LiveLeds/AstraDriver/README.md

# AstraDriver

[GitHub IO Page](https://liveleds.github.io/AstraDriver)
