LiveLeds/AstraDriver/index.md

---
layout: home
---

{% assign cacheBust = site.time | date:'?v=%s' %}


4 Channel LED Driver with PWM dimming input. LED2001PHR is the driver IC,
it can support up to 4A, 3V - 18V at 850KHz switching frequency.
Test plugs for each input and output.
Optimized for good dimming performance.
The board connects to [AstraControl](https://liveleds.github.io/AstraControl) ESP32-based control PCB uses WiFi with an external antenna and 5Mbps RS-485.
Direct copper heat-sink PCB for LED diode [AstraBeamLED](https://liveleds.github.io/AstraBeamLED).

### Production Details

The PCB went into production on **April 9, 2025**.

- **Git Tag:** `production-2025.04.09`

### Received Product

##### Front

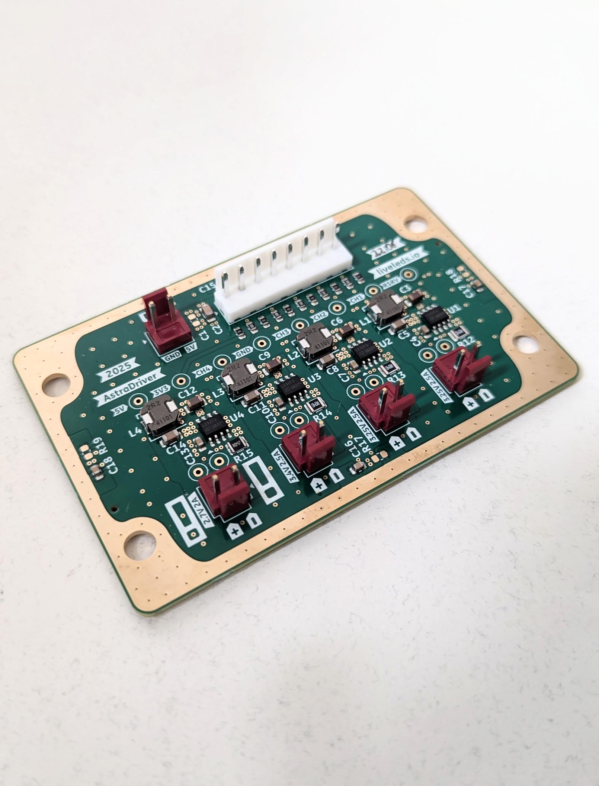
[picture p1: images/AstraDriver_Received_Front_Angled.jpg]
PCB Front


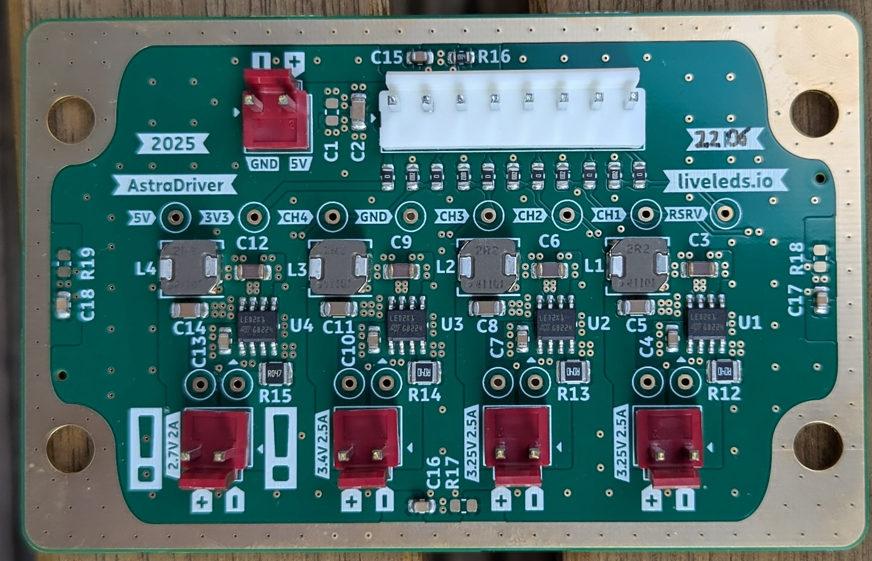
[picture p2: images/AstraDriver_Received_Front.jpg]
PCB Front


##### Back

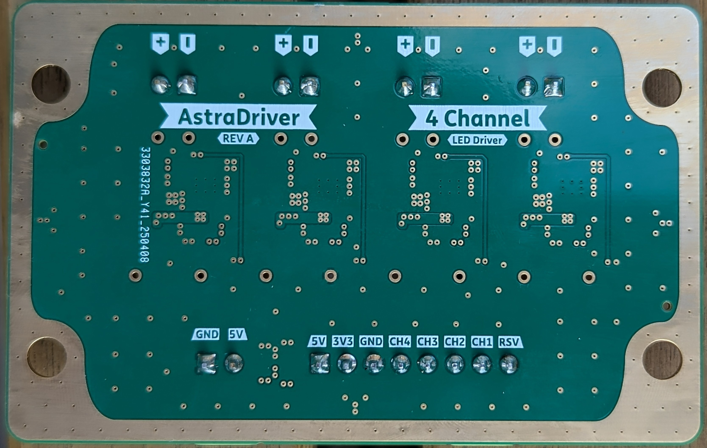
[picture p3: images/AstraDriver_Received_Back.jpg]
PCB Back


### Identified Issues

1. **Minor Coil Whine:**
  A very minor coil whine can be heard under full PWM operation, especially when going from 100% to 0%. It's not very critical for my use case but I fixed the issue by adding an electrolytic 1000uF capacitor into the test plug holes (5V and GND). Something to improve in the next revision. The existing 100uF ceramic is not performing well enough.

1. **Flicker at very low PWM:**
   When testing 14 bit PWM resolution the LEDs were flickering slightly at very low values (up to 150 around %1). It's was expected and I just limited it in software, it's still very dim and stable at 150. A potential solution is to use an N-Channel MOSFET to control which shunt resistor (current of 2.5A or 0.5A for example) is used and select the appropriate one for very low value to have a complete 0 to 100% range.
   An example of such an HDR approach can be found on Youtube here (8:36): [
Building My Ultimate LED Flashlight: Boost Driver Circuit Episode #1](https://www.youtube.com/watch?v=jCIWTuvKMyg) Credit to Engeneering Bo.

### Additional Notes

- Overall the whole project worked without significant issues on the first revision.
- The test plug hole were very useful to add an extra capacitor, debugging PWM and checking voltages.
  
### Continuous Integration and Repository Status





## Table of contents

- [Table of contents](#table-of-contents)
  - [Render Top Angled](#render-top-angled)
  - [Render Top](#render-top)
  - [Render Bottom](#render-bottom)
  - [Schematic](#schematic)
    - [Dark](#dark)
    - [Monochromatic](#monochromatic)
    - [Light](#light)
  - [Assembly](#assembly)
    - [Dark](#dark-1)
    - [Light](#light-1)
    - [Gerber viewer on tracespace.io](#gerber-viewer-on-tracespaceio)
  - [Interactive BOM](#interactive-bom)
  - [BOM](#bom)
  - [KiCad Revision Inspector (KiRI)](#kicad-revision-inspector-kiri)
    - [Dark](#dark-2)
    - [Light](#light-2)
  - [Downloads](#downloads)
    - [JLCPCB](#jlcpcb)
    - [Eurocircuits](#eurocircuits)
    - [3D Step](#3d-step)
- [Report](#report)
    - [ERC](#erc)
    - [DRC](#drc)
- [Know Issues](#know-issues)
- [Credits](#credits)

### Render Top Angled



### Render Top



### Render Bottom



### Schematic

#### Dark

- [Schematic Dark PDF]({{ "/documents/AstraDriver-schematic-dark.pdf" | absolute_url | append: cacheBust }})

#### Monochromatic

- [Schematic Monochromatic PDF]({{ "/documents/AstraDriver-schematic-mono.pdf" | absolute_url | append: cacheBust }})

#### Light

- [Schematic Light PDF]({{ "/documents/AstraDriver-schematic-default.pdf" | absolute_url | append: cacheBust }})

### Assembly

#### Dark

- [PCB Dark PDF]({{ "/documents/AstraDriver-pcb-dark.pdf" | absolute_url | append: cacheBust }})

#### Light

- [PCB Light PDF]({{ "/documents/AstraDriver-pcb-light.pdf" | absolute_url | append: cacheBust }})

#### Gerber viewer on tracespace.io

[https://tracespace.io/view/?boardUrl={{ "export/AstraDriver-JLCPCB.zip" | absolute_url | append: cacheBust }}](https://tracespace.io/view/?boardUrl={{ "export/AstraDriver-JLCPCB.zip" | absolute_url | append: cacheBust }})

### Interactive BOM

Check component locations by hovering over a specific component.
The visual elements might not be precise enough for pcb review but can be very useful since it's possible to pan and zoom.
Not all BOM columns are available here, for datasheet links see BOM below.

[IBOM HTML]({{ "/export/AstraDriver-ibom.html" | absolute_url | append: cacheBust }})

### BOM

All components with Values, References, Sheetpath and Links to the datasheet.

[BOM HTML]({{ "/export/AstraDriver-bom.html" | absolute_url | append: cacheBust }})

### KiCad Revision Inspector (KiRI)

KiCad Revision Inspector (KiRI) is a tool for comparing different versions of KiCad projects. It exports project revisions to SVG format for visual comparison using an onion skin view. This helps identify changes and errors in PCB designs. KiRI also includes a command line interface for generating viewable artifacts in any web browser.

View the PCB / Schematic in an interactive way, pan and zoom to see the details.

#### Dark

- [KiRi Dark]({{ "/KiRiDark/index.html" | absolute_url | append: cacheBust }})

#### Light

- [KiRi Light]({{ "/KiRiLight/index.html" | absolute_url | append: cacheBust }})

### Downloads

#### JLCPCB

- [JLCPCB Zip]({{ "export/AstraDriver-JLCPCB.zip" | absolute_url | append: cacheBust }})
- [JLCPCB BOM CSV]({{ "export/AstraDriver_bom_jlc.csv" | absolute_url | append: cacheBust }})
- [JLCPCB CPL CSV]({{ "export/AstraDriver_cpl_jlc.csv" | absolute_url | append: cacheBust }})

#### Eurocircuits

- [Eurocircuits Zip]({{ "export/AstraDriver-Eurocircuits.zip" | absolute_url | append: cacheBust }})
- [Eurocircuits BOM CSV]({{ "export/AstraDriver_bom_Eurocircuits.csv" | absolute_url | append: cacheBust }})
- [Eurocircuits CPL CSV]({{ "export/AstraDriver_cpl_Eurocircuits.csv" | absolute_url | append: cacheBust }})

#### 3D Step

- [3D Step]({{ "/AstraDriver-3D.step" | absolute_url | append: cacheBust }})

## Report

#### ERC

{% include_relative erc_validation.md %}

#### DRC

{% include_relative drc_validation.md %}

{% include_relative AstraDriver-report.md %}

## Know Issues

- TBD

## Credits

[KiCad EDA](https://www.kicad.org)

[KiBot](https://github.com/INTI-CMNB/KiBot)

[Amulet - Inspiration for awesome schematic and PCB](https://github.com/EPFLXplore/XRE_LeggedRobot_HW)

[tracespace view - Online Gerber Viewer](https://tracespace.io)
