LiveLeds/AstraDriver/dxf/AstraDriverRing.dxf

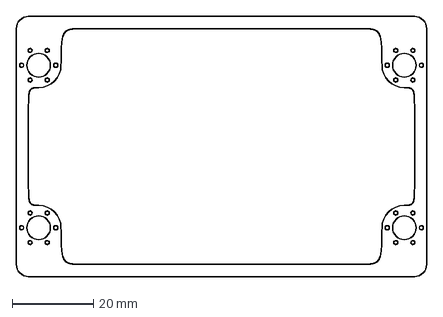
[picture p4: CAD file, 2025-02-16]
dxf/AstraDriverRing.dxf
101.0 x 64.0 mm
