LiveLeds/AstraDriver/dxf/AstraDriverEdge.dxf

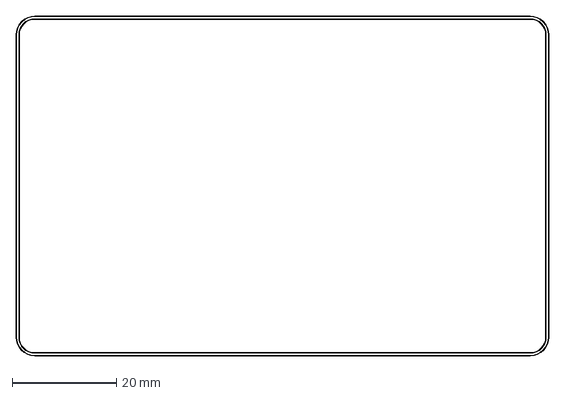
[picture p5: CAD file, 2025-02-16]
dxf/AstraDriverEdge.dxf
102.0 x 65.0 mm
