LiveLeds/AstraDriver/AstraDriverPCB/AstraDriver.kicad_pcb

## KiCad design AstraDriverPCB/AstraDriver.kicad_pcb (2025-04-04)

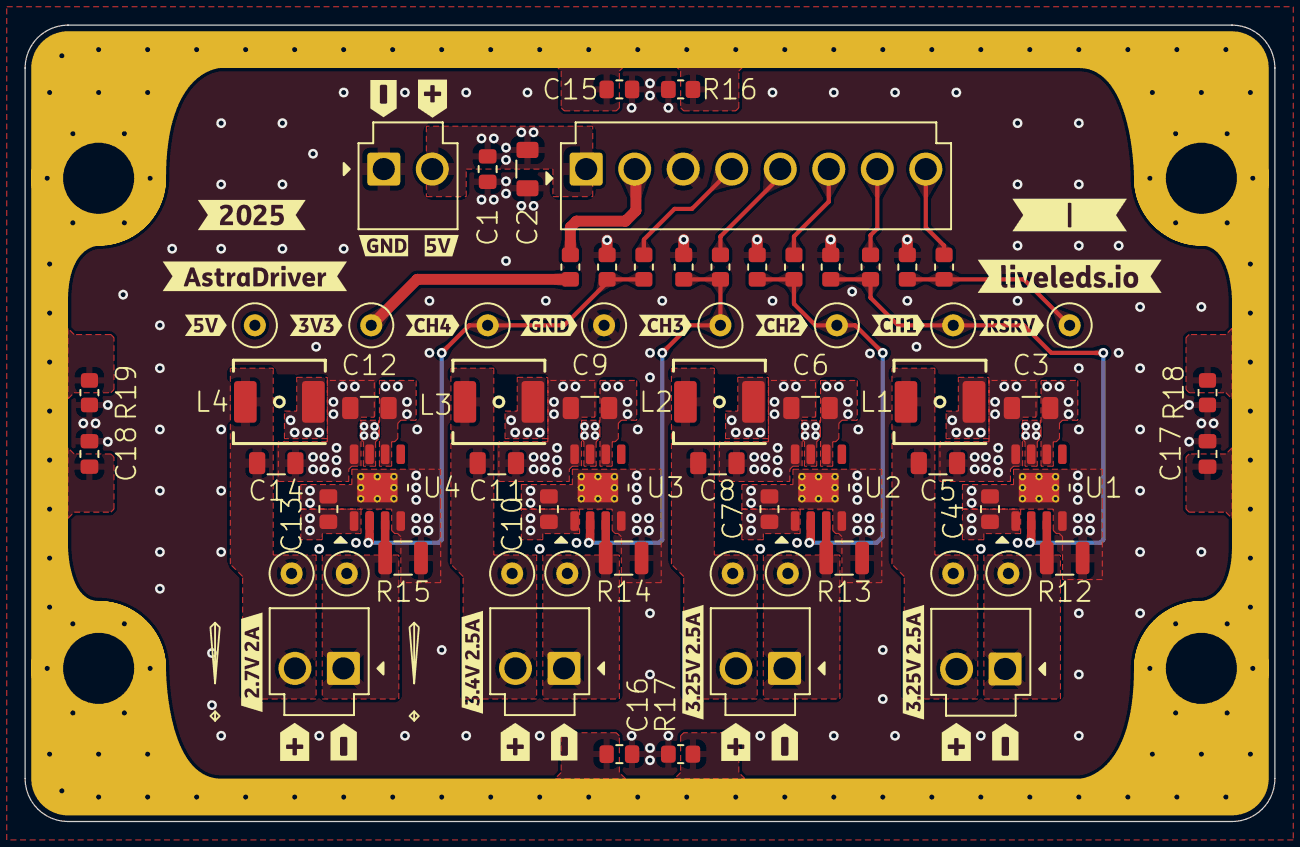
[picture p6: board AstraDriver.kicad_pcb from above]

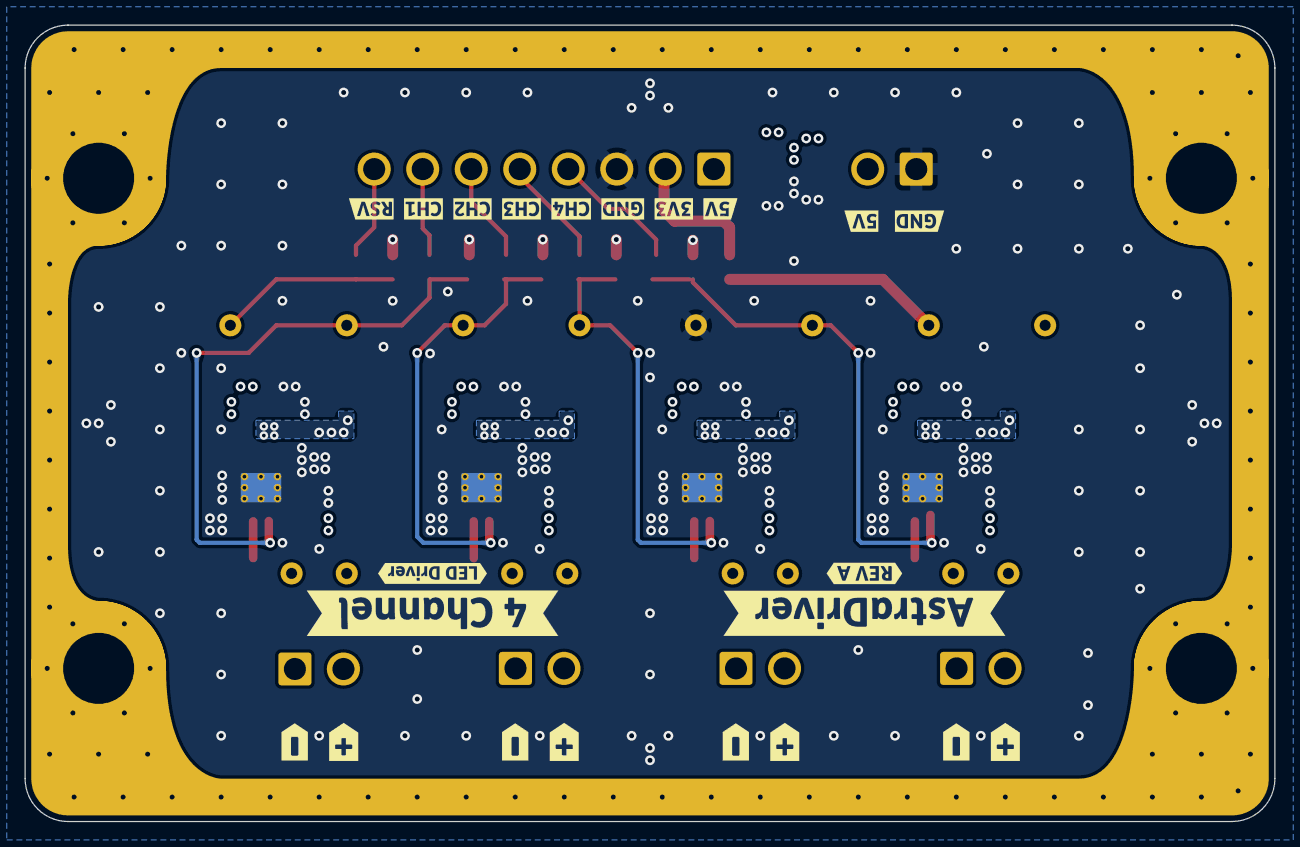
[picture p7: board AstraDriver.kicad_pcb from below]

Board: 4 copper layers, 102.0 x 65.0 mm, 118 parts (22 on the bottom side), 27 nets.

Parts:
C1: DNP; C_DNP_0805_2012Metric_Pad1.18x1.45mm_HandSolder
C2: 100u; C_1206_3216Metric_Pad1.33x1.80mm_HandSolder
C3, C6, C9, C12: 22u; C_1206_3216Metric_Pad1.33x1.80mm_HandSolder
C4, C7, C10, C13: 1u; C_0805_2012Metric_Pad1.18x1.45mm_HandSolder
C5, C8, C11, C14: 4u7; C_1206_3216Metric_Pad1.33x1.80mm_HandSolder
C15, C16, C17, C18: 10n; C_0805_2012Metric_Pad1.18x1.45mm_HandSolder
CN1: JST VH 8 PIN (CLONE); JST_VH_CLONE_B8P-VH-B_1x08_P3.96mm_Vertical
CN2, CN3, CN4, CN5, CN6: JST VH 2 PIN; JST_VH_B2P-VH-B_1x02_P3.96mm_Vertical
L1, L2, L3, L4: 2u2H; L_TDK_SPM6530T-2R2M
R1, R2, R3, R4, R5, R6: 0; R_0805_2012Metric_Pad1.20x1.40mm_HandSolder
R7, R8, R9, R10, R11: 10k; R_0805_2012Metric_Pad1.20x1.40mm_HandSolder
R12, R13, R14: 40m; R_1210_3225Metric
R15: 47m; R_1210_3225Metric
R16: 1M; R_0805_2012Metric_Pad1.20x1.40mm_HandSolder
R17, R18, R19: DNP; R_DNP_0805_2012Metric_Pad1.20x1.40mm_HandSolder
RING1: AstraDriver_Ground_Ring
TP1, TP2, TP3, TP4, TP5, TP6, TP7, TP8, TP9, TP10, TP11, TP12, TP13, TP14, TP15, TP16: TestPoint_Thimble; TestPoint_Loop_D3.50mm_Drill0.9mm_Beaded
U1, U2, U3, U4: LED2001PHR; U_LED2001PHR_HSOP8
kibuzzard-67ACE9FE: G***; kibuzzard-67ACE9FE
kibuzzard-67ACEA04: G***; kibuzzard-67ACEA04
kibuzzard-67B0BCB5: G***; kibuzzard-67B0BCB5
kibuzzard-67B1DE0F: G***; kibuzzard-67B1DE0F
kibuzzard-67B1DE14: G***; kibuzzard-67B1DE14
kibuzzard-67B1DE99, kibuzzard-67B1DE99#2, kibuzzard-67B1DE99#3, kibuzzard-67B1DE99#4: G***; kibuzzard-67B1DE99
kibuzzard-67B1DEA2, kibuzzard-67B1DEA2#2, kibuzzard-67B1DEA2#3, kibuzzard-67B1DEA2#4: G***; kibuzzard-67B1DEA2
kibuzzard-67B1DFB0: G***; kibuzzard-67B1DFB0
kibuzzard-67B1DFC8: G***; kibuzzard-67B1DFC8
kibuzzard-67EB9EA5: G***; kibuzzard-67EB9EA5
kibuzzard-67EB9FE0: G***; kibuzzard-67EB9FE0
kibuzzard-67263EBF: G***; kibuzzard-67263EBF
kibuzzard-67263F1F: G***; kibuzzard-67263F1F
kibuzzard-67263F3C: G***; kibuzzard-67263F3C
kibuzzard-67263F3F: G***; kibuzzard-67263F3F
kibuzzard-67263F8C: G***; kibuzzard-67263F8C
kibuzzard-67263F35: G***; kibuzzard-67263F35
kibuzzard-67263F87: G***; kibuzzard-67263F87
kibuzzard-67264EAC: G***; kibuzzard-67264EAC
kibuzzard-67264F3E: G***; kibuzzard-67264F3E
kibuzzard-67264F60: G***; kibuzzard-67264F60
kibuzzard-67264F65: G***; kibuzzard-67264F65
kibuzzard-67609A4F: G***; kibuzzard-67609A4F
kibuzzard-67609A54: G***; kibuzzard-67609A54
kibuzzard-67609A62: G***; kibuzzard-67609A62
kibuzzard-67718F9D: G***; kibuzzard-67718F9D
kibuzzard-67718FA4: G***; kibuzzard-67718FA4
kibuzzard-672647E1: G***; kibuzzard-672647E1
kibuzzard-676095B5: G***; kibuzzard-676095B5
kibuzzard-676095BC: G***; kibuzzard-676095BC
kibuzzard-676095C8: G***; kibuzzard-676095C8
kibuzzard-676095D3: G***; kibuzzard-676095D3
kibuzzard-6726414E, kibuzzard-6726414E#2, kibuzzard-6726414E#3, kibuzzard-6726414E#4, kibuzzard-6726414E#5: G***; kibuzzard-6726414E
kibuzzard-6760963B: G***; kibuzzard-6760963B
kibuzzard-67264157, kibuzzard-67264157#2, kibuzzard-67264157#3, kibuzzard-67264157#4, kibuzzard-67264157#5: G***; kibuzzard-67264157
kibuzzard-67609643: G***; kibuzzard-67609643

Connections:
+3V3: R6.2, TP4.1
+5V: C1.2, C2.2, C3.2, C4.2, C6.2, C7.2, C9.2, C10.2, C12.2, C13.2, CN1.1, CN2.2, TP3.1, U1.1 (VINA), U1.6 (VINSW), U2.1 (VINA), U2.6 (VINSW), U3.1 (VINA), U3.6 (VINSW), U4.1 (VINA), U4.6 (VINSW)
/Block Diagram/3V3_R: CN1.2, R6.1
/Block Diagram/CH1_LED+: C5.2, CN6.2, L1.2, TP16.1
/Block Diagram/CH1_LED-: CN6.1, R12.2, TP15.1, U1.3 (FB)
/Block Diagram/CH2_LED+: C8.2, CN5.2, L2.2, TP14.1
/Block Diagram/CH2_LED-: CN5.1, R13.2, TP13.1, U2.3 (FB)
/Block Diagram/CH3_LED+: C11.2, CN4.2, L3.2, TP12.1
/Block Diagram/CH3_LED-: CN4.1, R14.2, TP11.1, U3.3 (FB)
/Block Diagram/CH4_LED+: C14.2, CN3.2, L4.2, TP10.1
/Block Diagram/CH4_LED-: CN3.1, R15.2, TP9.1, U4.3 (FB)
/Block Diagram/Channel 1 Blue and CY 2.5A/SW_OUT: L1.1, U1.7 (SW)
/Block Diagram/Channel 2 Blue and CY 2.5A/SW_OUT: L2.1, U2.7 (SW)
/Block Diagram/Channel 3 Green 2.5A/SW_OUT: L3.1, U3.7 (SW)
/Block Diagram/Channel 4 Red 2A/SW_OUT: L4.1, U4.7 (SW)
/Block Diagram/DIM_1: R4.2, R11.2, TP8.1, U1.2 (DIM)
/Block Diagram/DIM_2: R3.2, R10.2, TP7.1, U2.2 (DIM)
/Block Diagram/DIM_3: R2.2, R9.2, TP6.1, U3.2 (DIM)
/Block Diagram/DIM_4: R1.2, R8.2, TP5.1, U4.2 (DIM)
/Block Diagram/PWM_CH1: CN1.7, R4.1
/Block Diagram/PWM_CH2: CN1.6, R3.1
/Block Diagram/PWM_CH3: CN1.5, R2.1
/Block Diagram/PWM_CH4: CN1.4, R1.1
/Block Diagram/RESERVED: CN1.8, R5.1
/Block Diagram/RSRV: R5.2, R7.2, TP2.1
CHASSIS: C15.2, C16.2, C17.2, C18.2, R16.2, R17.2, R18.2, R19.2, RING1.1 (2)
GND: C1.1, C2.1, C3.1, C4.1, C5.1, C6.1, C7.1, C8.1, C9.1, C10.1, C11.1, C12.1, C13.1, C14.1, C15.1, C16.1, C17.1, C18.1, CN1.3, CN2.1, R7.1, R8.1, R9.1, R10.1, R11.1, R12.1, R13.1, R14.1, R15.1, R16.1, R17.1, R18.1, R19.1, TP1.1, U1.4 (AGND), U1.8 (PGND), U1.9 (EP), U2.4 (AGND), U2.8 (PGND), U2.9 (EP), U3.4 (AGND), U3.8 (PGND), U3.9 (EP), U4.4 (AGND), U4.8 (PGND), U4.9 (EP)
