LiveLeds/AstraDriver/(commit log)

2024-10-06 Correct pcb and schematic
    [AstraDriver.kicad_pcb, AstraDriver.kicad_sch]
2024-10-06 Update board dimensions and center
    [AstraDriver.kicad_pcb]
2024-10-11 Added all schematic components
    [AstraDriver.kicad_pcb, block_diagram.kicad_sch, led_driver.kicad_sch, led_driver_2A.kicad_sch, led_driver_2A5.kicad_sch, led_driver_3A.kicad_sch, misc.kicad_sch, overview.kicad_sch]
2024-10-15 Finished layout
    [AstraDriver.kicad_pcb, block_diagram.kicad_sch, led_driver_2A5.kicad_sch]
2024-10-15 Added extra caps, cleanup
    [AstraDriver.kicad_pcb, block_diagram.kicad_sch, led_driver_2A.kicad_sch, led_driver_2A5.kicad_sch]
2024-11-02 Finished silkscreen and board
    [AstraDriver.kicad_pcb, block_diagram.kicad_sch, led_driver_2A.kicad_sch, led_driver_2A5.kicad_sch]
2024-11-02 DFM fixes
    [AstraDriver.kicad_pcb]
2024-11-02 Reduce samples
2024-11-02 More dfm
    [AstraDriver.kicad_pcb]
2024-11-02 Update for kiri
    [AstraDriver.kicad_pcb]
2024-11-02 Tweak angled render
    [AstraDriver.kicad_pcb]
2024-12-15 New layout in progress
    [AstraDriver.kicad_pcb, block_diagram.kicad_sch, led_driver_2A.kicad_sch, led_driver_2A5.kicad_sch, led_driver_blue_cy_2A5.kicad_sch, led_driver_green_2A5.kicad_sch, led_driver_red_2A.kicad_sch, misc.kicad_sch]
2024-12-16 Finished layout and silkscreen, and stitching
    [AstraDriver.kicad_pcb]
2024-12-18 Prepare for review, cleanup
    [AstraDriver.kicad_pcb, block_diagram.kicad_sch, led_driver_blue_cy_2A5.kicad_sch, led_driver_green_2A5.kicad_sch, led_driver_red_2A.kicad_sch, misc.kicad_sch, overview.kicad_sch]
2024-12-18 Tweaks for JLC
    [AstraDriver.kicad_pcb, overview.kicad_sch]
2024-12-18 Tweak renders and 100 samples
2024-12-20 1 sample
2024-12-20 Some via tweaks
    [AstraDriver.kicad_pcb]
2024-12-20 Tweak vias
    [AstraDriver.kicad_pcb]
2024-12-20 Fix fab
    [AstraDriver.kicad_pcb]
2024-12-30 Added another 2 PIN VH connector for power, cleanup
    [AstraDriver.kicad_pcb, block_diagram.kicad_sch, led_driver_blue_cy_2A5.kicad_sch, led_driver_green_2A5.kicad_sch, led_driver_red_2A.kicad_sch, misc.kicad_sch]
2025-02-09 Rough layout
    [AstraDriver.kicad_pcb, misc.kicad_sch]
2025-02-09 2 samples
2025-02-16 Layout complete
    [AstraDriver.kicad_pcb]
2025-02-16 Add dxf for ring
    [AstraDriverEdge.dxf, AstraDriverRing.dxf]
2025-04-01 SLK tweaks
    [AstraDriver.kicad_pcb]
2025-04-01 Update vh to clone
    [AstraDriver.kicad_pcb, block_diagram.kicad_sch]
2025-04-04 Fix bad pour after teardrops
    [AstraDriver.kicad_pcb]
2025-04-04 Updated thermal spokes
    [AstraDriver.kicad_pcb]
2025-04-04 Updated dimensions
    [AstraDriver.kicad_pcb]
2025-04-04 Larger area for led power connectors
    [AstraDriver.kicad_pcb]
2025-04-04 Increase inductor connection
    [AstraDriver.kicad_pcb]
2025-06-29 100 samples
